f0reachARR/YC265A0-Debug/pin_assign.md

# ピンアサイン

## MIDI (制御用)

- SDSP_TX: IO17
- SDSP_RX: IO18
- KDSP_TX: IO46
- KDSP_RX: IO9

## MIDI (音源)

- TG1A_TX: IO3
- TG1B_TX: IO7
- TG1_RX: IO15
- TG2A_TX: IO16
- TG2B_TX: IO5
- TG2_RX: IO6

## I2C (TLV320AIC32X4用)

- I2C_SCL: IO45
- I2C_SDA: IO48

## GPIO (TLV320AIC32X4用)

- AIC32X4_RESET: IO38

## I2S (YC265A0入出力用)

※TLV320AIC32X4にはYC265A0のI2S出力が接続されています。

- I2S_MCLK: IO13
- I2S_BCLK: IO14
- I2S_WCLK(LRCK): IO21
- I2S_OUT_ADPCM: IO12
- I2S_OUT_MP3_0: IO11
- I2S_OUT_MP3_1: IO10
- I2S_IN(TDM): IO4
