f0reachARR/YC265A0-Debug/pcb/YC265A0-Debug.kicad_pcb

## KiCad design pcb/YC265A0-Debug.kicad_pcb (2026-01-30)

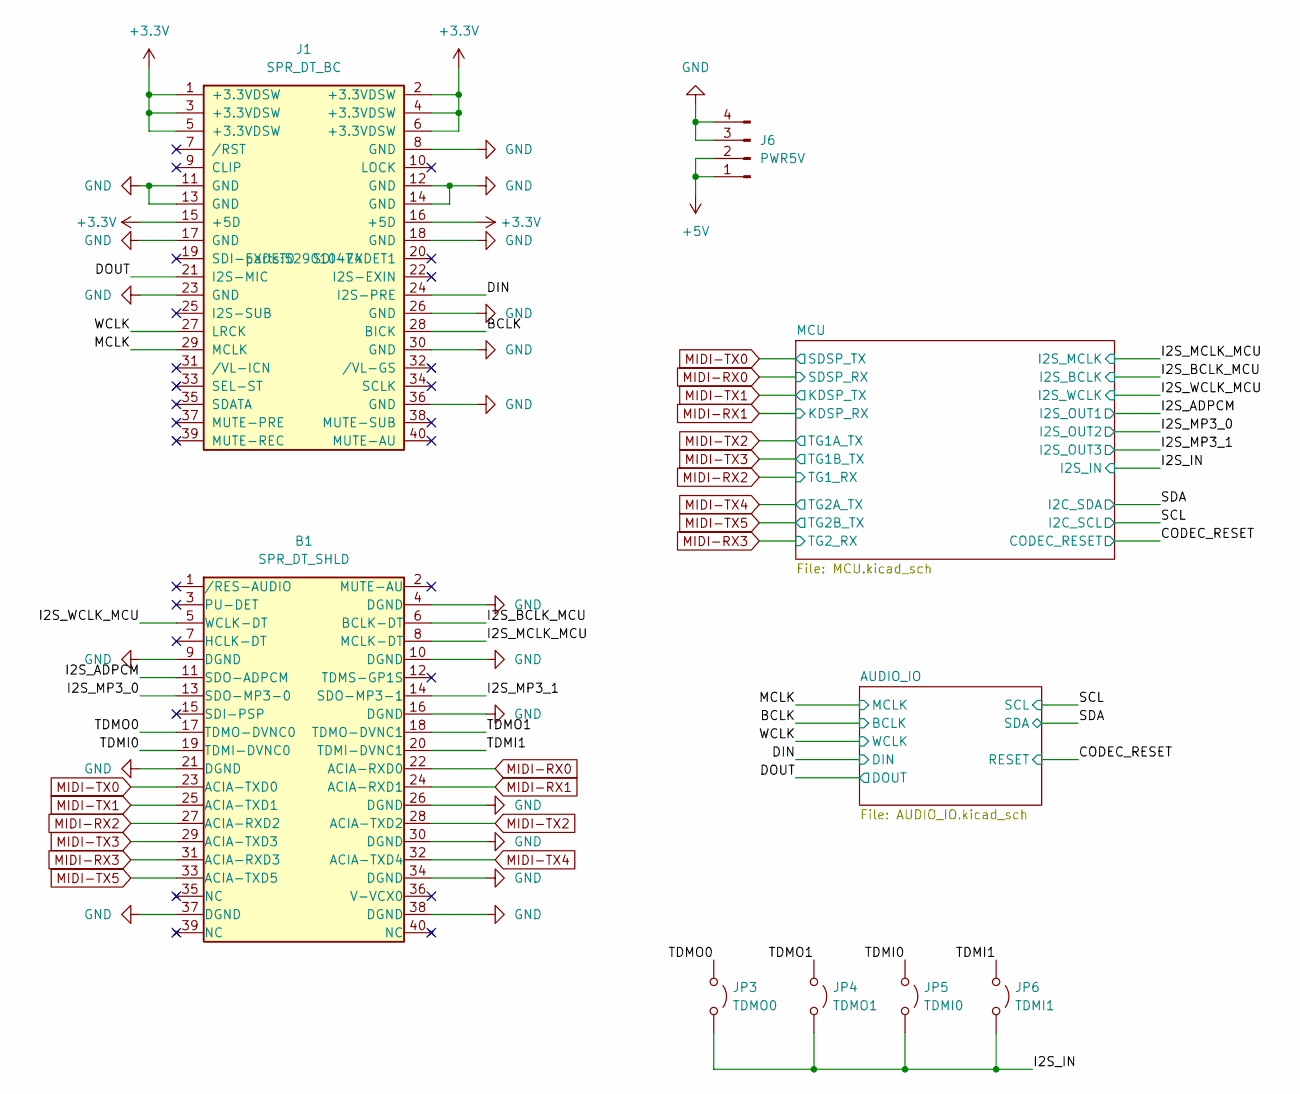
[picture p1: schematic YC265A0-Debug.kicad_sch, YC265A0 Debugger Board]

Parts:
B1: SPR_DT_SHLD; JST_SHD_SM40B-SRDS-G-TF_2x20_P1.0_Right_Angle
J1: SPR_DT_BC; 529010474
J6: PWR5V; JST_PH_S4B-PH-SM4-TB_1x04-1MP_P2.00mm_Horizontal
JP3: TDMO0; PinHeader_1x02_P2.54mm_Vertical
JP4: TDMO1; PinHeader_1x02_P2.54mm_Vertical
JP5: TDMI0; PinHeader_1x02_P2.54mm_Vertical
JP6: TDMI1; PinHeader_1x02_P2.54mm_Vertical

Connections:
+3.3V: J1.1 (+3.3VDSW), J1.2 (+3.3VDSW), J1.3 (+3.3VDSW), J1.4 (+3.3VDSW), J1.5 (+3.3VDSW), J1.6 (+3.3VDSW), J1.15 (+5D), J1.16 (+5D); also elsewhere on the board
+5V: J6.1, J6.2; also elsewhere on the board
/BCLK: J1.28 (BICK); also elsewhere on the board
/DIN: J1.24 (I2S-PRE); also elsewhere on the board
/DOUT: J1.21 (I2S-MIC); also elsewhere on the board
/I2S_ADPCM: B1.11 (SDO-ADPCM); also elsewhere on the board
/I2S_BCLK_MCU: B1.6 (BCLK-DT); also elsewhere on the board
/I2S_IN: JP3.2 (B), JP4.2 (B), JP5.2 (B), JP6.2 (B); also elsewhere on the board
/I2S_MCLK_MCU: B1.8 (MCLK-DT); also elsewhere on the board
/I2S_MP3_0: B1.13 (SDO-MP3-0); also elsewhere on the board
/I2S_MP3_1: B1.14 (SDO-MP3-1); also elsewhere on the board
/I2S_WCLK_MCU: B1.5 (WCLK-DT); also elsewhere on the board
/MCLK: J1.29 (MCLK); also elsewhere on the board
/TDMI0: B1.19 (TDMI-DVNC0), JP5.1 (A)
/TDMI1: B1.20 (TDMI-DVNC1), JP6.1 (A)
/TDMO0: B1.17 (TDMO-DVNC0), JP3.1 (A)
/TDMO1: B1.18 (TDMO-DVNC1), JP4.1 (A)
/WCLK: J1.27 (LRCK); also elsewhere on the board
GND: B1.4 (DGND), B1.9 (DGND), B1.10 (DGND), B1.16 (DGND), B1.21 (DGND), B1.26 (DGND), B1.30 (DGND), B1.34 (DGND), B1.37 (DGND), B1.38 (DGND), J1.8 (GND), J1.11 (GND), J1.12 (GND), J1.13 (GND), J1.14 (GND), J1.17 (GND), J1.18 (GND), J1.23 (GND), J1.26 (GND), J1.30 (GND), J1.36 (GND), J6.3, J6.4; also elsewhere on the board
MIDI-RX0: B1.22 (ACIA-RXD0); also elsewhere on the board
MIDI-RX1: B1.24 (ACIA-RXD1); also elsewhere on the board
MIDI-RX2: B1.27 (ACIA-RXD2); also elsewhere on the board
MIDI-RX3: B1.31 (ACIA-RXD3); also elsewhere on the board
MIDI-TX0: B1.23 (ACIA-TXD0); also elsewhere on the board
MIDI-TX1: B1.25 (ACIA-TXD1); also elsewhere on the board
MIDI-TX2: B1.28 (ACIA-TXD2); also elsewhere on the board
MIDI-TX3: B1.29 (ACIA-TXD3); also elsewhere on the board
MIDI-TX4: B1.32 (ACIA-TXD4); also elsewhere on the board
MIDI-TX5: B1.33 (ACIA-TXD5); also elsewhere on the board

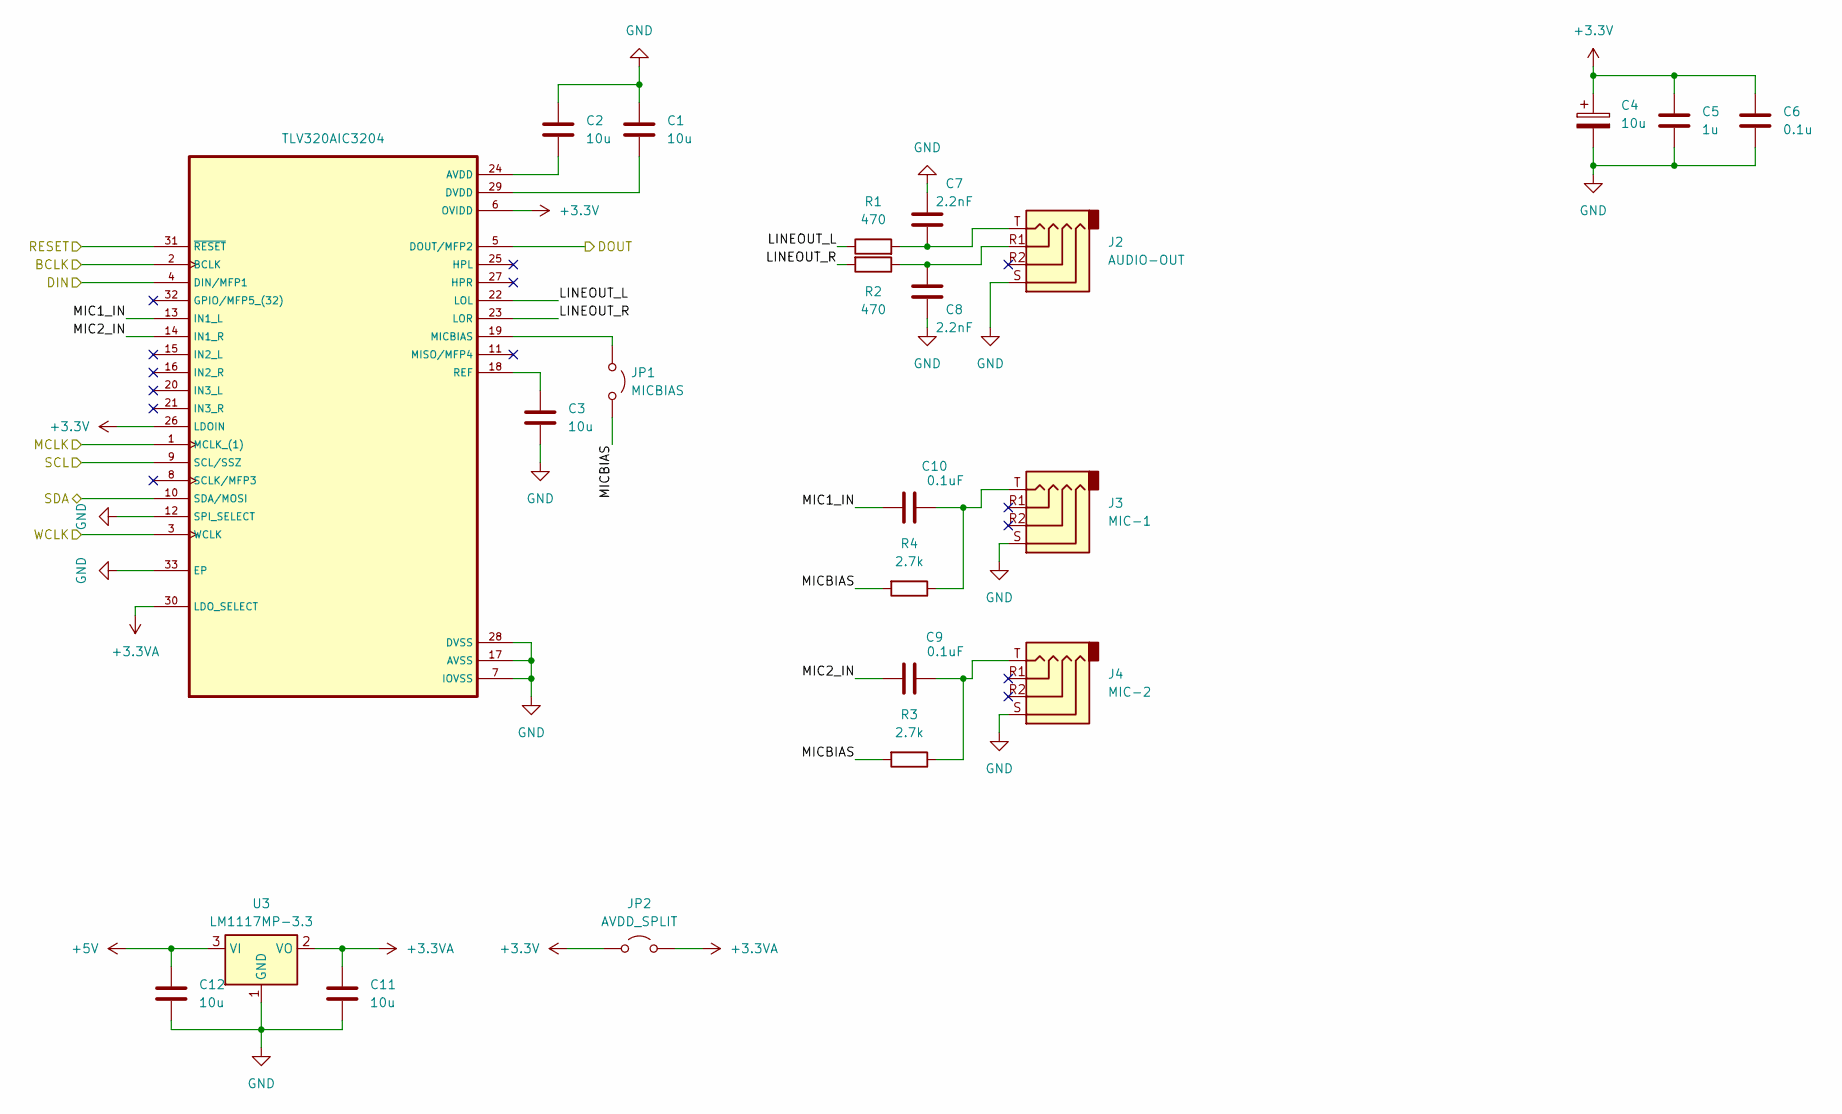
[picture p2: schematic AUDIO_IO.kicad_sch, DAC/ADC IO parts]

Parts:
C1, C2, C3, C4, C11, C12: 10u; C_0603_1608Metric_Pad1.08x0.95mm_HandSolder
C5: 1u; C_0603_1608Metric_Pad1.08x0.95mm_HandSolder
C6: 0.1u; C_0603_1608Metric_Pad1.08x0.95mm_HandSolder
C7, C8: 2.2nF; C_0603_1608Metric_Pad1.08x0.95mm_HandSolder; LCSC C1531
C9, C10: 0.1uF; C_0603_1608Metric_Pad1.08x0.95mm_HandSolder; LCSC C1531
J2: AUDIO-OUT; Jack_3.5mm_PJ320D_Horizontal
J3: MIC-1; Jack_3.5mm_PJ320D_Horizontal
J4: MIC-2; Jack_3.5mm_PJ320D_Horizontal
JP1: MICBIAS; PinHeader_1x02_P2.54mm_Vertical
JP2: AVDD_SPLIT; PinHeader_1x02_P2.54mm_Vertical
R1, R2: 470; R_0603_1608Metric_Pad0.98x0.95mm_HandSolder; LCSC C25117
R3, R4: 2.7k; R_0603_1608Metric_Pad0.98x0.95mm_HandSolder
U1: TLV320AIC3204; VQFN-32-1EP_5x5mm_P0.5mm_EP3.5x3.5mm
U3: LM1117MP-3.3; SOT-223-3_TabPin2

Connections:
+3.3V: C4.1, C5.2, C6.2, JP2.1 (A), U1.6 (OVIDD), U1.26 (LDOIN); also elsewhere on the board
+3.3VA: C11.2, JP2.2 (B), U1.30 (LDO_SELECT), U3.2 (VO)
+5V: C12.2, U3.3 (VI); also elsewhere on the board
/AUDIO_IO/LINEOUT_L: R1.1, U1.22 (LOL)
/AUDIO_IO/LINEOUT_R: R2.2, U1.23 (LOR)
/AUDIO_IO/MIC1_IN: C10.2, U1.13 (IN1_L)
/AUDIO_IO/MIC2_IN: C9.2, U1.14 (IN1_R)
/AUDIO_IO/MICBIAS: JP1.2 (B), R3.2, R4.2
/BCLK: U1.2 (BCLK); also elsewhere on the board
/CODEC_RESET: U1.31 (~RESET); also elsewhere on the board
/DIN: U1.4 (DIN/MFP1); also elsewhere on the board
/DOUT: U1.5 (DOUT/MFP2); also elsewhere on the board
/MCLK: U1.1 (MCLK_(1)); also elsewhere on the board
/SCL: U1.9 (SCL/SSZ); also elsewhere on the board
/SDA: U1.10 (SDA/MOSI); also elsewhere on the board
/WCLK: U1.3 (WCLK); also elsewhere on the board
GND: C1.2, C2.2, C3.1, C4.2, C5.1, C6.1, C7.2, C8.1, C11.1, C12.1, J2.S, J3.S, J4.S, U1.7 (IOVSS), U1.12 (SPI_SELECT), U1.17 (AVSS), U1.28 (DVSS), U1.33 (EP), U3.1 (GND); also elsewhere on the board
unnamed: C7.1, J2.T, R1.2
unnamed: C8.2, J2.R1, R2.1
unnamed: C9.1, J4.T, R3.1
unnamed: C10.1, J3.T, R4.1
unnamed: JP1.1 (A), U1.19 (MICBIAS)
unnamed: C2.1, U1.24 (AVDD)
unnamed: C1.1, U1.29 (DVDD)
unnamed: C3.2, U1.18 (REF)

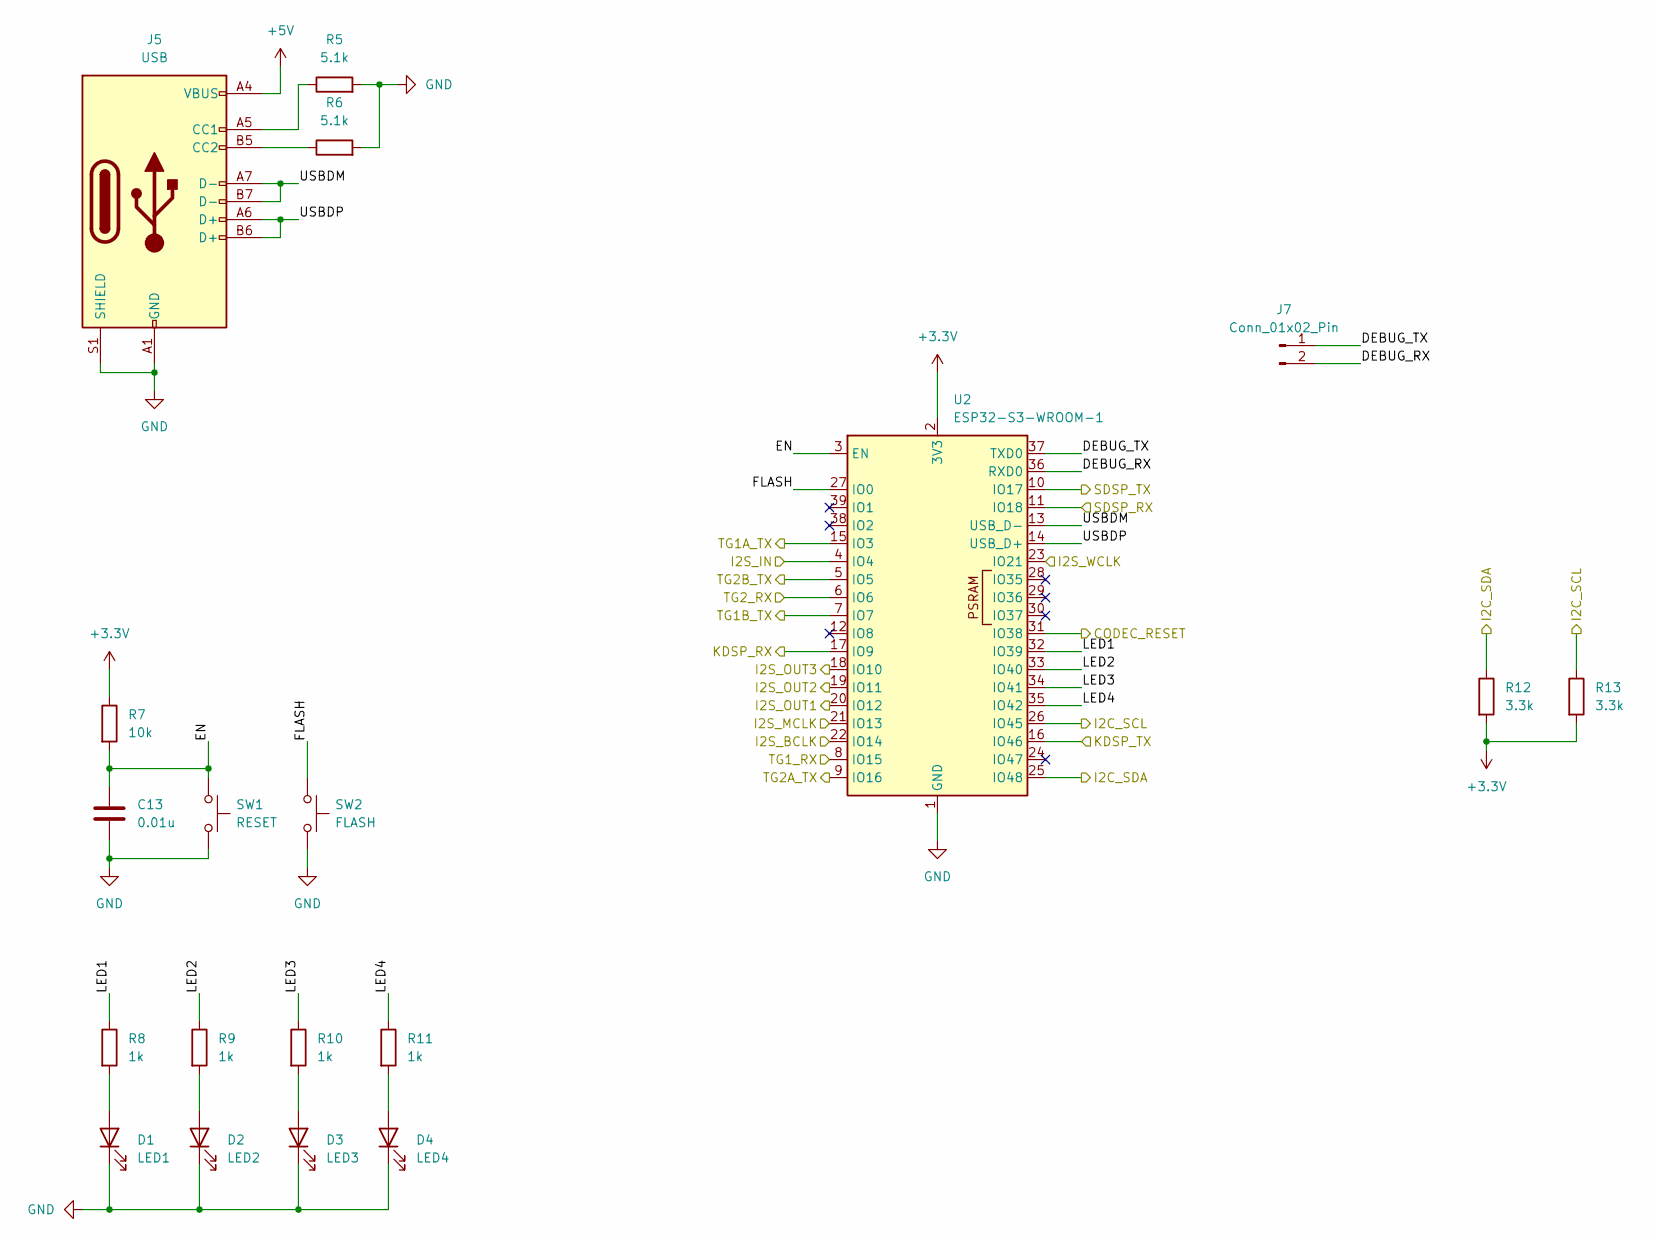
[picture p3: schematic MCU.kicad_sch]

Parts:
C13: 0.01u; C_0603_1608Metric_Pad1.08x0.95mm_HandSolder
D1: LED1; LED_0603_1608Metric_Pad1.05x0.95mm_HandSolder
D2: LED2; LED_0603_1608Metric_Pad1.05x0.95mm_HandSolder
D3: LED3; LED_0603_1608Metric_Pad1.05x0.95mm_HandSolder
D4: LED4; LED_0603_1608Metric_Pad1.05x0.95mm_HandSolder
J5: USB; USB_C_Receptacle_Palconn_UTC16-G
J7: Conn_01x02_Pin; PinHeader_1x02_P2.54mm_Horizontal
R5, R6: 5.1k; R_0603_1608Metric_Pad0.98x0.95mm_HandSolder
R7: 10k; R_0603_1608Metric_Pad0.98x0.95mm_HandSolder
R8, R9, R10, R11: 1k; R_0603_1608Metric_Pad0.98x0.95mm_HandSolder
R12, R13: 3.3k; R_0603_1608Metric_Pad0.98x0.95mm_HandSolder
SW1: RESET; SW_PUSH_6mm_H8mm
SW2: FLASH; SW_PUSH_6mm_H8mm
U2: ESP32-S3-WROOM-1

Connections:
+3.3V: R7.1, R12.2, R13.2, U2.2 (3V3); also elsewhere on the board
+5V: J5.A4 (VBUS), J5.A9 (VBUS), J5.B4 (VBUS), J5.B9 (VBUS); also elsewhere on the board
/CODEC_RESET: U2.31 (IO38); also elsewhere on the board
/I2S_ADPCM: U2.20 (IO12); also elsewhere on the board
/I2S_BCLK_MCU: U2.22 (IO14); also elsewhere on the board
/I2S_IN: U2.4 (IO4); also elsewhere on the board
/I2S_MCLK_MCU: U2.21 (IO13); also elsewhere on the board
/I2S_MP3_0: U2.19 (IO11); also elsewhere on the board
/I2S_MP3_1: U2.18 (IO10); also elsewhere on the board
/I2S_WCLK_MCU: U2.23 (IO21); also elsewhere on the board
/MCU/DEBUG_RX: J7.2, U2.36 (RXD0)
/MCU/DEBUG_TX: J7.1, U2.37 (TXD0)
/MCU/EN: C13.1, R7.2, SW1.1, U2.3 (EN)
/MCU/FLASH: SW2.1, U2.27 (IO0)
/MCU/LED1: R8.1, U2.32 (IO39)
/MCU/LED2: R9.1, U2.33 (IO40)
/MCU/LED3: R10.1, U2.34 (IO41)
/MCU/LED4: R11.1, U2.35 (IO42)
/MCU/USBDM: J5.A7 (D-), J5.B7 (D-), U2.13 (USB_D-)
/MCU/USBDP: J5.A6 (D+), J5.B6 (D+), U2.14 (USB_D+)
/SCL: R13.1, U2.26 (IO45); also elsewhere on the board
/SDA: R12.1, U2.25 (IO48); also elsewhere on the board
GND: C13.2, D1.1 (K), D2.1 (K), D3.1 (K), D4.1 (K), J5.A1 (GND), J5.A12 (GND), J5.B1 (GND), J5.B12 (GND), J5.S1 (SHIELD), R5.2, R6.2, SW1.2, SW2.2, U2.1 (GND), U2.40 (GND), U2.41 (GND); also elsewhere on the board
MIDI-RX0: U2.11 (IO18); also elsewhere on the board
MIDI-RX1: U2.17 (IO9); also elsewhere on the board
MIDI-RX2: U2.8 (IO15); also elsewhere on the board
MIDI-RX3: U2.6 (IO6); also elsewhere on the board
MIDI-TX0: U2.10 (IO17); also elsewhere on the board
MIDI-TX1: U2.16 (IO46); also elsewhere on the board
MIDI-TX2: U2.15 (IO3); also elsewhere on the board
MIDI-TX3: U2.7 (IO7); also elsewhere on the board
MIDI-TX4: U2.9 (IO16); also elsewhere on the board
MIDI-TX5: U2.5 (IO5); also elsewhere on the board
unnamed: D1.2 (A), R8.2
unnamed: D2.2 (A), R9.2
unnamed: D3.2 (A), R10.2
unnamed: D4.2 (A), R11.2
unnamed: J5.A5 (CC1), R5.1
unnamed: J5.B5 (CC2), R6.1

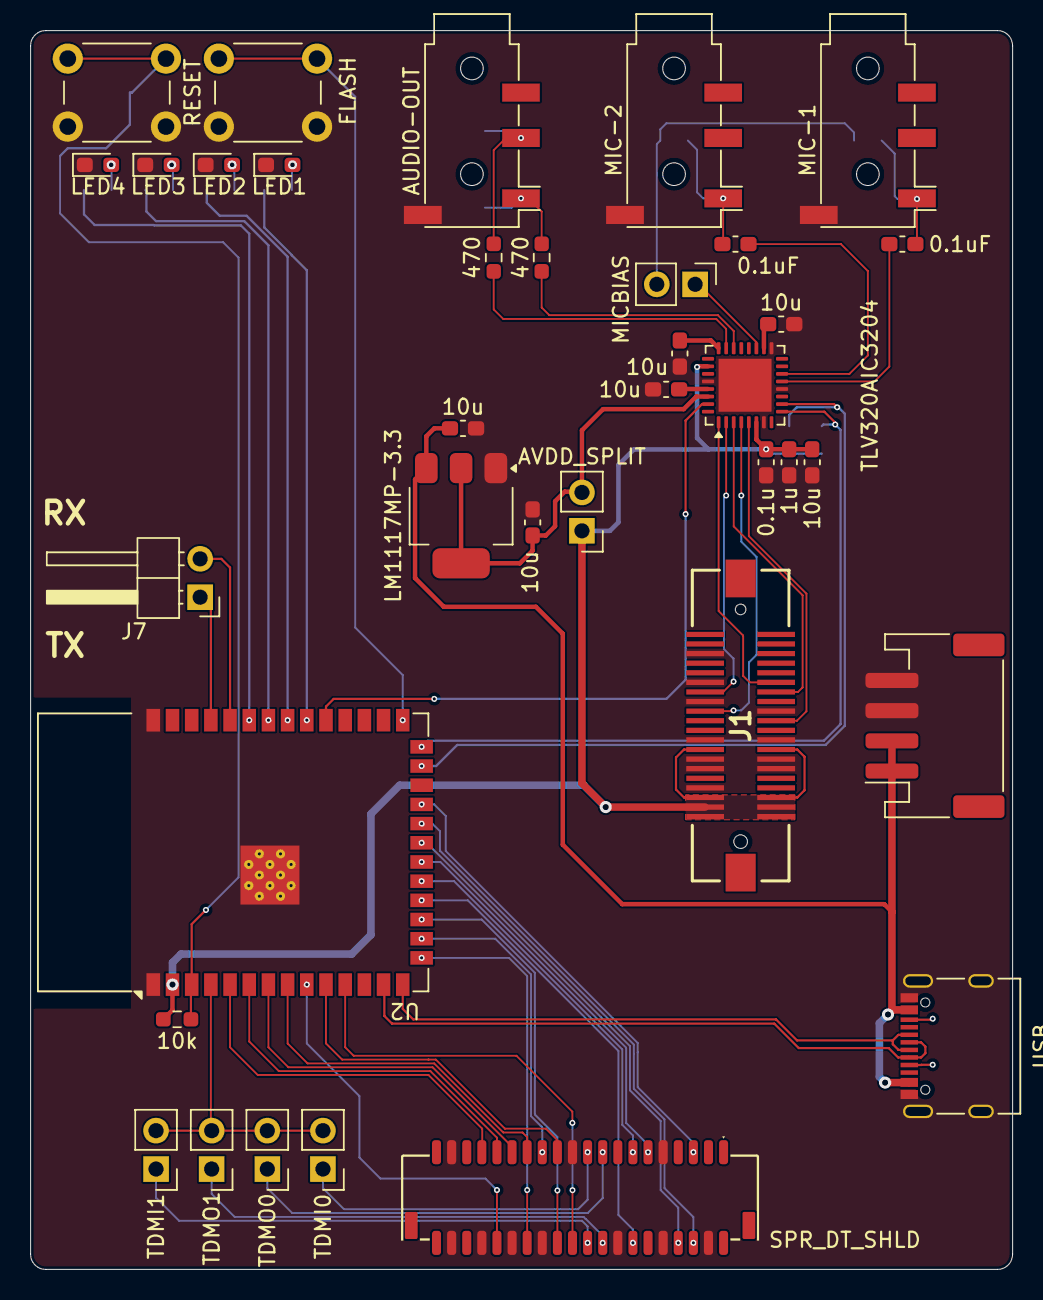
[picture p4: board YC265A0-Debug.kicad_pcb from above]

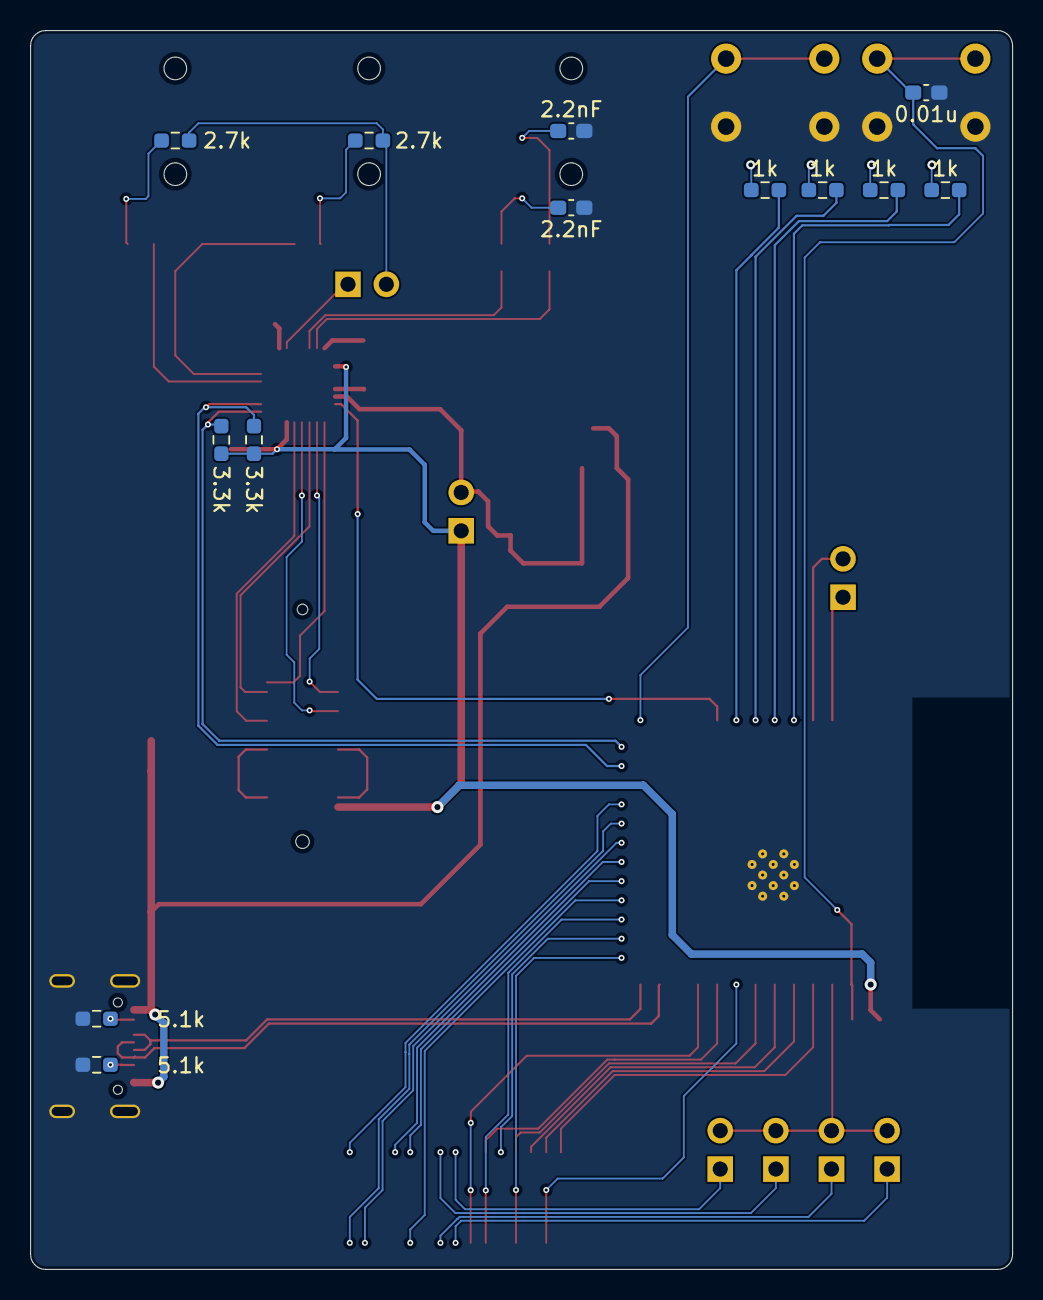
[picture p5: board YC265A0-Debug.kicad_pcb from below]

Board: 2 copper layers, 65.0 x 82.0 mm, 49 parts (13 on the bottom side), 62 nets.
