f0reachARR/YC265A0-Debug/(commit log)

2025-11-13 add midi conn
    [YC265A0-Debug.kicad_pcb, YC265A0-Debug.kicad_sch]
2026-01-30 sample 1
    [AUDIO_IO.kicad_sch, MCU.kicad_sch, YC265A0-Debug.kicad_pcb, YC265A0-Debug.kicad_sch]
2026-01-30 rename pcb dir
    [AUDIO_IO.kicad_sch, MCU.kicad_sch, YC265A0-Debug.kicad_pcb, YC265A0-Debug.kicad_sch]
2026-01-30 remove reference driver
